David-Khutsishvili/3D-embedded-scanner/(commit log)

2026-09-07 servo init
2026-09-11 added laser_test
2026-09-14 Firmware: serial command protocol (START/STOP/PING) and reset() fix
    The Arduino now idles after boot and is controlled from the PC:
    - READY after boot and after every scan (platform reset)
    - PING -> PONG when idle, BUSY while scanning
    - START runs the unchanged scanning_routine()
    - STOP aborts between rotation steps, reports
    SCAN_STOPPED {vertical_angle,theta,h}, then SCAN_END
    - non-blocking fixed-size command buffer (no String / heap use)
    reset() now also resets rotational_angle and d_rotational_angle, so a
    second scan in the same power-on starts at theta=0 rotating forward.
    Scan output was verified identical to the previous firmware using a host-side
    g++ build of the sketch with stubbe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
    [scan.ino]
2026-09-14 Add shared scanner_core package; CLIs become thin wrappers
    scanner_core (no Qt; only visual.py imports pyvista):
    - protocol: line protocol constants, Measurement/StopPoint, parse_line()
    - links: ScannerLink interface + SerialLink (pyserial), list_serial_ports()
    - simulator: SimulatedLink replays a scan file speaking the firmware protocol
    - scan_files: <name>.json (unchanged format) + <name>.meta.json sidecar
    - capture_session: CaptureSession with autosave, wait_for_ready() handshake
    - reconstruction: point cloud + closed surface mesh from the ring grid
    - visual: conversion to PyVista PolyData
    Reconstruction fix: the plate turns counter-clockwise as theta grows, so
    points are mapped with R_z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
    [capture_session.py, links.py, protocol.py, reconstruction.py, scan_files.py, simulator.py]
2026-09-14 Add PySide6 + PyVista desktop app (Scan and Viewer tabs)
    - scanner_app.py: entry point (python src/gui/scanner_app.py [--scans-dir])
    - scanner_ui/link_worker.py: serial I/O in a QThread (LinkWorker/LinkConnection)
    - scanner_ui/scan_tab.py: ScanController state machine (PING handshake,
    fresh readiness check before START, STOP, BUSY/Error/link-loss handling,
    capture + autosave) and the Scan tab UI (device incl. simulator, name,
    Start/Stop, progress, optional live 3D preview, log)
    - scanner_ui/viewer_tab.py: scans list with status badges, scan info, and a
    3D view with a Points/Mesh toggle, Mirror, Smooth, point size, reset view
    and PNG screenshot
    - scanner_ui/scene.py: shared height-c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
